maribu/badge-wip/riot-badge.kicad_pcb

## KiCad design riot-badge.kicad_pcb (2025-09-30)

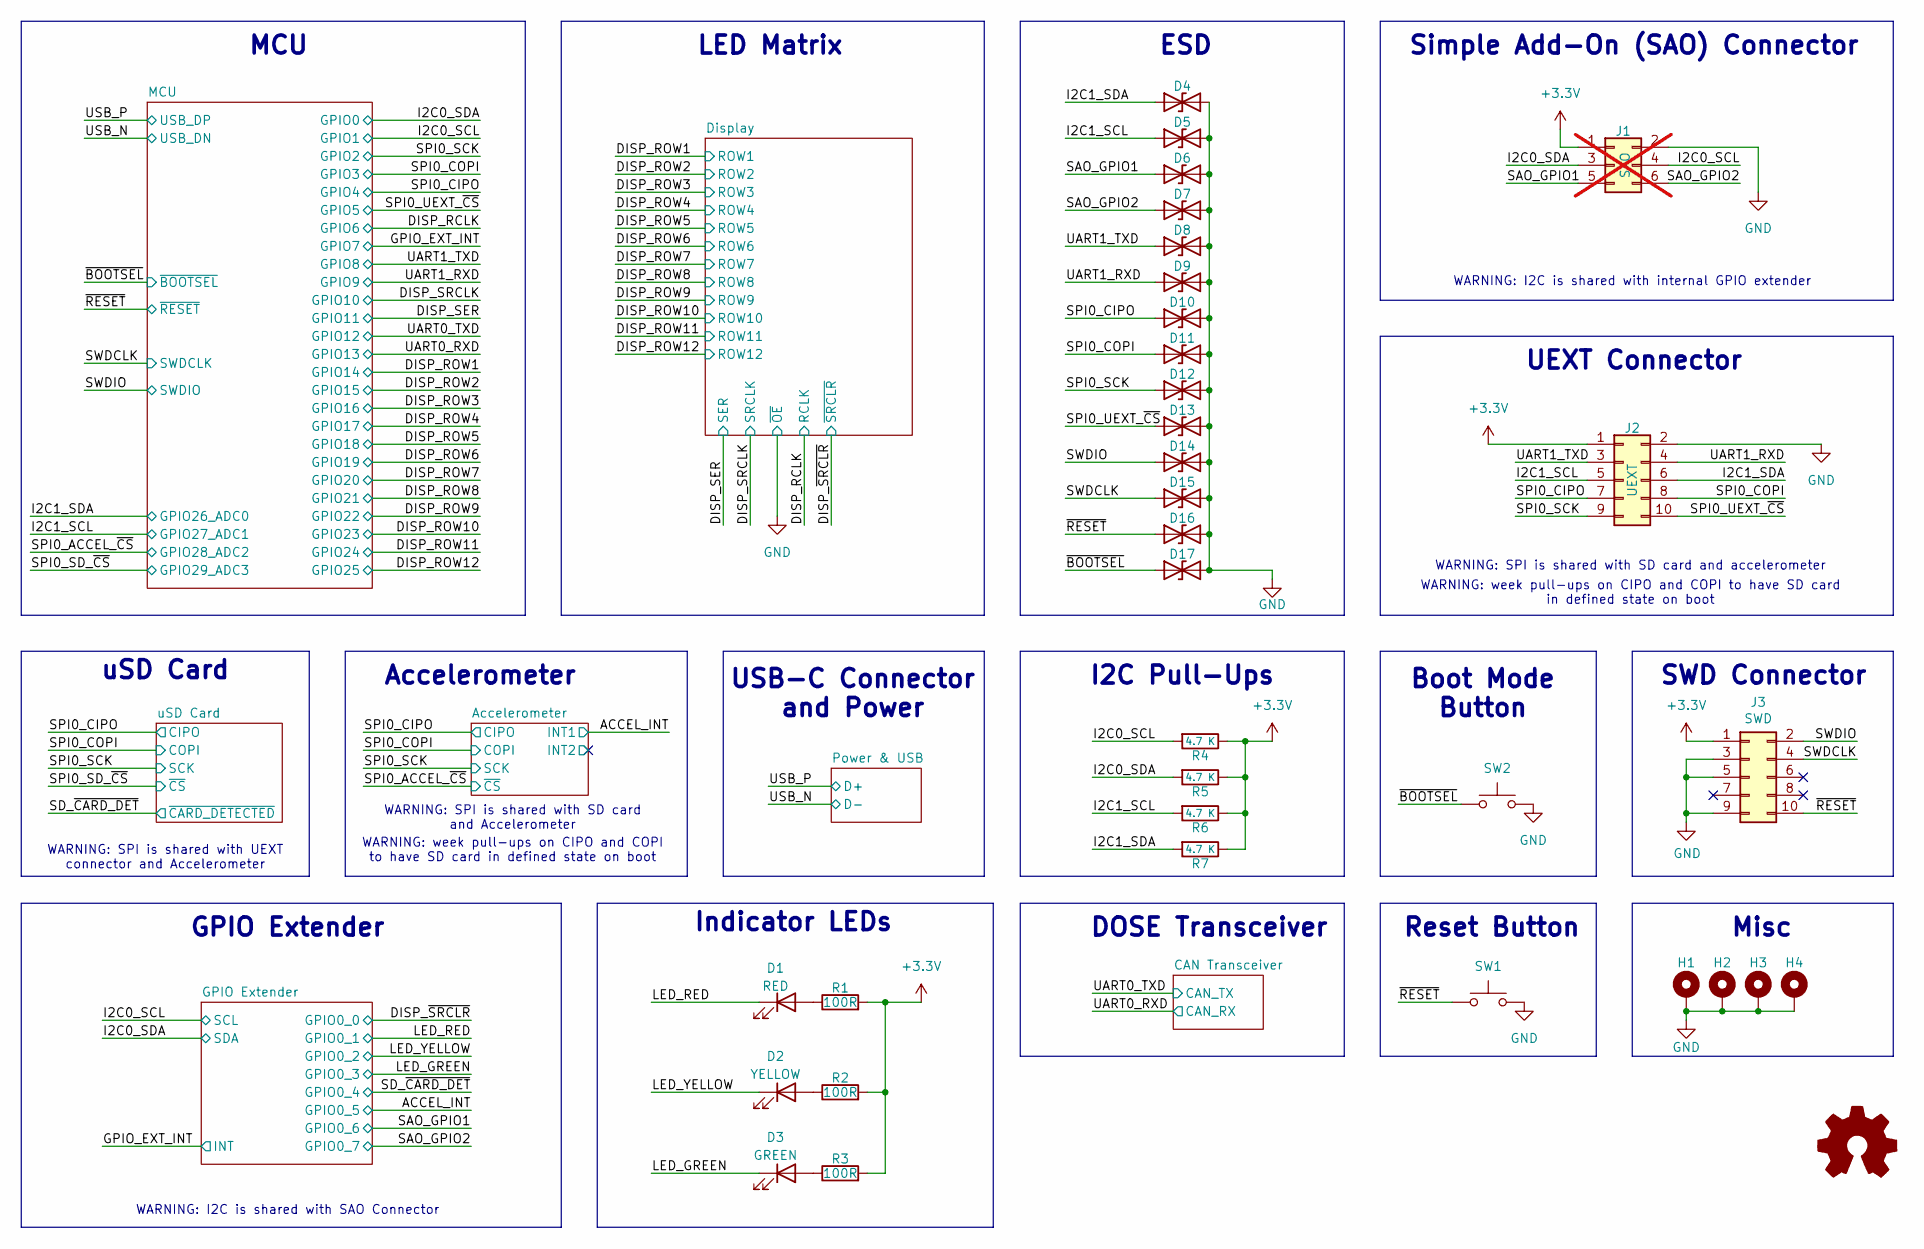
[picture p1: schematic riot-badge.kicad_sch, Badge for RIOT Summit '25]

Parts:
D1: RED; LED_0603_1608Metric; LCSC C2286
D2: YELLOW; LED_0805_2012Metric; LCSC C2296
D3: GREEN; LED_0805_2012Metric; LCSC C2297
D4, D5, D6, D7, D8, D9, D10, D11, D12, D13, D14, D15, D16, D17: D_TVS; SOD-882_L1.0-W0.6-BI; LCSC C7420372
G1: Logo_Open_Hardware_Small; OSHW-Logo2_7.3x6mm_SilkScreen
H1, H2, H3, H4: MountingHole_Pad; MountingHole_2.2mm_M2_DIN965_Pad
J1: SAO; PinSocket_2x03_P2.54mm_Vertical_SAO; LCSC C18164972; not fitted
J2: UEXT; HDR-TH_10P-P2.54-V-F-R2-C5-S2.54_GREENCONN; LCSC C7434489
J3: SWD; CONN-SMD_FTSH-105-01-L-DV-K-TR; LCSC C448647
R1, R2, R3: 100R; R_0402_1005Metric; LCSC C25076
R4, R5, R6, R7: 4.7 K; R_0402_1005Metric; LCSC C25900
SW1, SW2: SW_Push; SW-SMD_4P-L5.1-W5.1-P3.70-LS6.5-TL_H1.5; LCSC C318884

Connections:
+3.3V: J1.1, J2.1, J3.1, R1.2, R2.2, R3.2, R4.1, R5.1, R6.1, R7.1; also elsewhere on the board
/I2C0_SCL: J1.4, R4.2; also elsewhere on the board
/I2C0_SDA: J1.3, R5.2; also elsewhere on the board
/I2C1_SCL: D5.1 (A1), J2.5, R6.2; also elsewhere on the board
/I2C1_SDA: D4.1 (A1), J2.6, R7.2; also elsewhere on the board
/LED_GREEN: D3.1 (K); also elsewhere on the board
/LED_RED: D1.1 (K); also elsewhere on the board
/LED_YELLOW: D2.1 (K); also elsewhere on the board
/SAO_GPIO1: D6.1 (A1), J1.5; also elsewhere on the board
/SAO_GPIO2: D7.1 (A1), J1.6; also elsewhere on the board
/SPI0_CIPO: D10.1 (A1), J2.7; also elsewhere on the board
/SPI0_COPI: D11.1 (A1), J2.8; also elsewhere on the board
/SPI0_SCK: D12.1 (A1), J2.9; also elsewhere on the board
/SPI0_UEXT_~CS: D13.1 (A1), J2.10; also elsewhere on the board
/SWDCLK: D15.1 (A1), J3.4; also elsewhere on the board
/SWDIO: D14.1 (A1), J3.2; also elsewhere on the board
/UART1_RXD: D9.1 (A1), J2.4; also elsewhere on the board
/UART1_TXD: D8.1 (A1), J2.3; also elsewhere on the board
/~BOOTSEL: D17.1 (A1), SW2.1; also elsewhere on the board
/~RESET: D16.1 (A1), J3.10, SW1.1; also elsewhere on the board
GND: D4.2 (A2), D5.2 (A2), D6.2 (A2), D7.2 (A2), D8.2 (A2), D9.2 (A2), D10.2 (A2), D11.2 (A2), D12.2 (A2), D13.2 (A2), D14.2 (A2), D15.2 (A2), D16.2 (A2), D17.2 (A2), H1.1, H2.1, H3.1, H4.1, J1.2, J2.2, J3.3, J3.5, J3.9, SW1.2, SW2.2; also elsewhere on the board
unnamed: D1.2 (A), R1.1
unnamed: D2.2 (A), R2.1
unnamed: D3.2 (A), R3.1

Notes on the sheet:
UEXT Connector
Misc
uSD Card
GPIO Extender
Boot Mode Button
Indicator LEDs
WARNING: week pull-ups on CIPO and COPI to have SD card in defined state on boot
Reset Button
LED Matrix
WARNING: SPI is shared with UEXT connector and Accelerometer
DOSE Transceiver
ESD
WARNING: SPI is shared with SD card and accelerometer
I2C Pull-Ups
WARNING: I2C is shared with internal GPIO extender
WARNING: I2C is shared with SAO Connector
Simple Add-On (SAO) Connector
SWD Connector
WARNING: week pull-ups on CIPO and COPI to have SD card in defined state on boot
USB-C Connector and Power
WARNING: SPI is shared with SD card and Accelerometer
MCU
Accelerometer

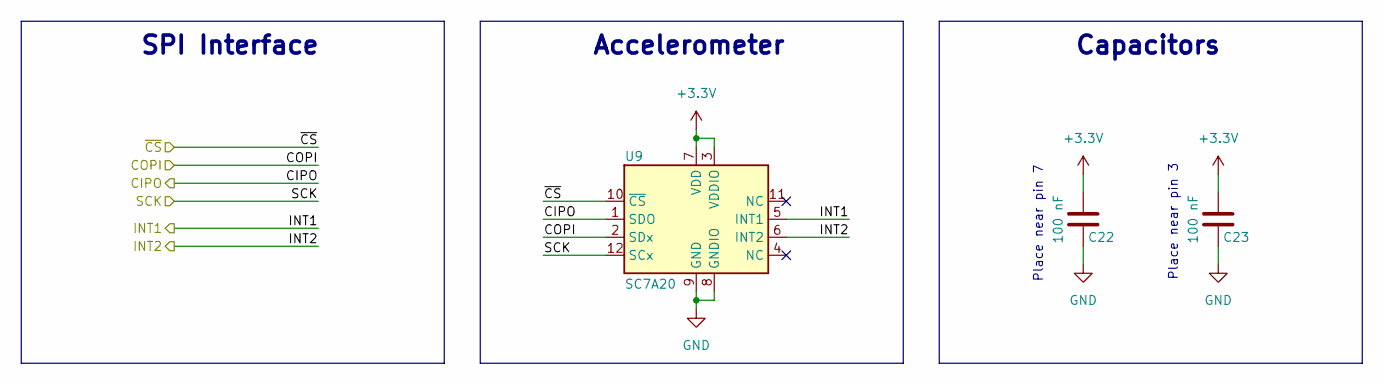
[picture p2: schematic accelerometer.kicad_sch]

Parts:
C22, C23: 100 nF; C_0402_1005Metric; LCSC C1525
U9: SC7A20; LGA-12_2x2mm_P0.5mm

Connections:
+3.3V: C22.1, C23.1, U9.3 (VDDIO), U9.7 (VDD); also elsewhere on the board
/ACCEL_INT: U9.5 (INT1); also elsewhere on the board
/Accelerometer/INT2: U9.6 (INT2)
/SPI0_ACCEL_~CS: U9.10 (~CS); also elsewhere on the board
/SPI0_CIPO: U9.1 (SDO); also elsewhere on the board
/SPI0_COPI: U9.2 (SDx); also elsewhere on the board
/SPI0_SCK: U9.12 (SCx); also elsewhere on the board
GND: C22.2, C23.2, U9.8 (GNDIO), U9.9 (GND); also elsewhere on the board

Notes on the sheet:
SPI Interface
Capacitors
Place near pin 7
Place near pin 3
Accelerometer

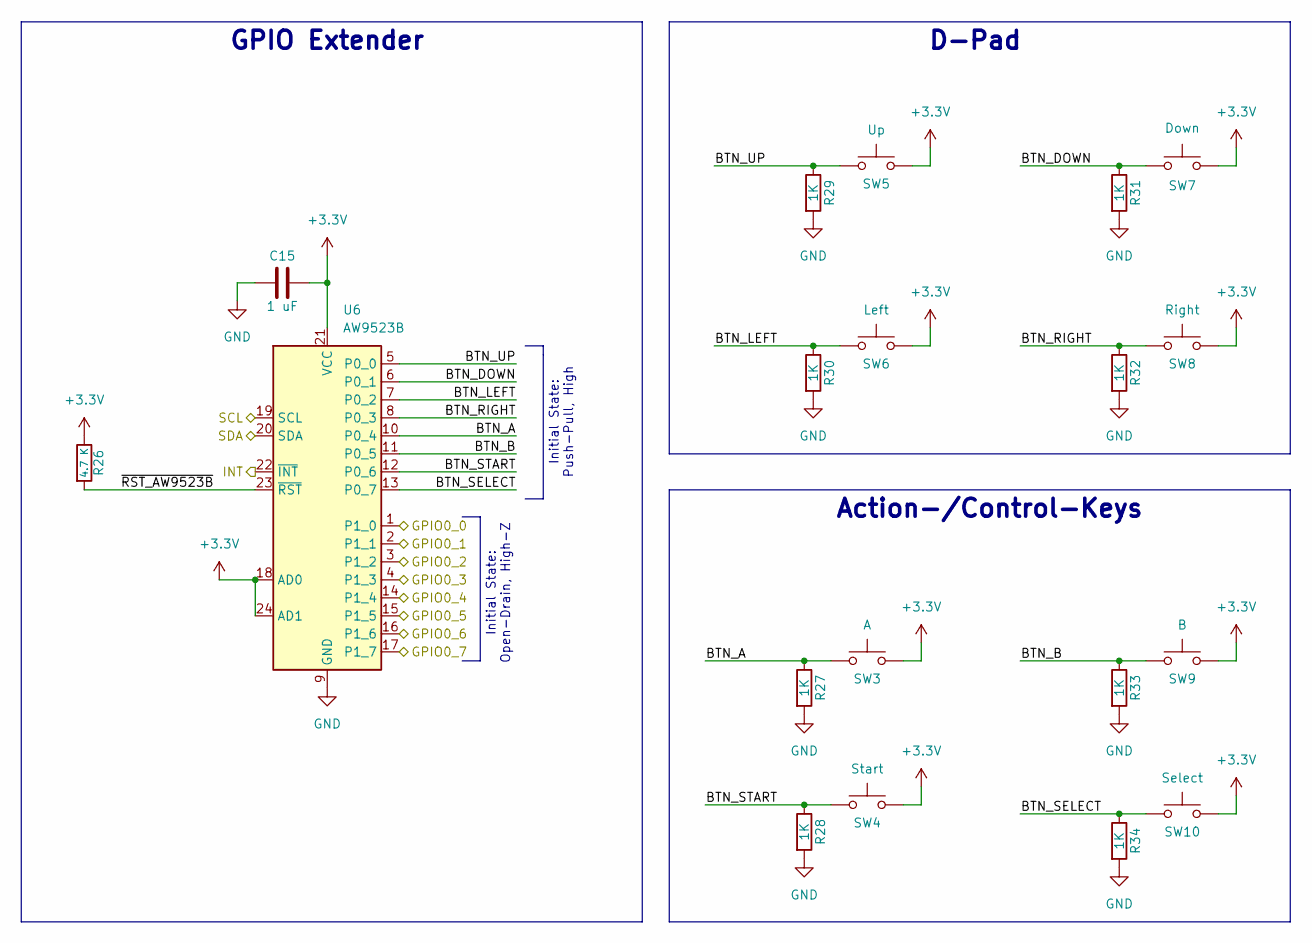
[picture p3: schematic gpio_extender.kicad_sch, Badge for RIOT Summit '25]

Parts:
C15: 1 uF; C_0402_1005Metric; LCSC C52923
R26: 4.7 K; R_0402_1005Metric; LCSC C25900
R27, R28, R29, R30, R31, R32, R33, R34: 1K; R_0402_1005Metric; LCSC C11702
SW3, SW4, SW5, SW6, SW7, SW8, SW9, SW10: SW_Push; SW-SMD_4P-L5.1-W5.1-P3.70-LS6.5-TL_H1.5; LCSC C318884
U6: AW9523B; QFN-24-1EP_4x4mm_P0.5mm_EP2.7x2.7mm

Connections:
+3.3V: C15.2, R26.1, SW3.2, SW4.2, SW5.2, SW6.2, SW7.2, SW8.2, SW9.2, SW10.2, U6.18 (AD0), U6.21 (VCC), U6.24 (AD1); also elsewhere on the board
/ACCEL_INT: U6.15 (P1_5); also elsewhere on the board
/DISP_~SRCLR: U6.1 (P1_0); also elsewhere on the board
/GPIO Extender/BTN_A: R27.1, SW3.1, U6.10 (P0_4)
/GPIO Extender/BTN_B: R33.1, SW9.1, U6.11 (P0_5)
/GPIO Extender/BTN_DOWN: R31.1, SW7.1, U6.6 (P0_1)
/GPIO Extender/BTN_LEFT: R30.1, SW6.1, U6.7 (P0_2)
/GPIO Extender/BTN_RIGHT: R32.1, SW8.1, U6.8 (P0_3)
/GPIO Extender/BTN_SELECT: R34.1, SW10.1, U6.13 (P0_7)
/GPIO Extender/BTN_START: R28.1, SW4.1, U6.12 (P0_6)
/GPIO Extender/BTN_UP: R29.1, SW5.1, U6.5 (P0_0)
/GPIO Extender/~RST_AW9523B: R26.2, U6.23 (~RST)
/GPIO_EXT_INT: U6.22 (~INT); also elsewhere on the board
/I2C0_SCL: U6.19 (SCL); also elsewhere on the board
/I2C0_SDA: U6.20 (SDA); also elsewhere on the board
/LED_GREEN: U6.4 (P1_3); also elsewhere on the board
/LED_RED: U6.2 (P1_1); also elsewhere on the board
/LED_YELLOW: U6.3 (P1_2); also elsewhere on the board
/SAO_GPIO1: U6.16 (P1_6); also elsewhere on the board
/SAO_GPIO2: U6.17 (P1_7); also elsewhere on the board
/SD_~CARD_DET: U6.14 (P1_4); also elsewhere on the board
GND: C15.1, R27.2, R28.2, R29.2, R30.2, R31.2, R32.2, R33.2, R34.2, U6.9 (GND), U6.25 (GND); also elsewhere on the board

Notes on the sheet:
Initial State: Push-Pull, High
D-Pad
Action-/Control-Keys
GPIO Extender
Initial State: Open-Drain, High-Z

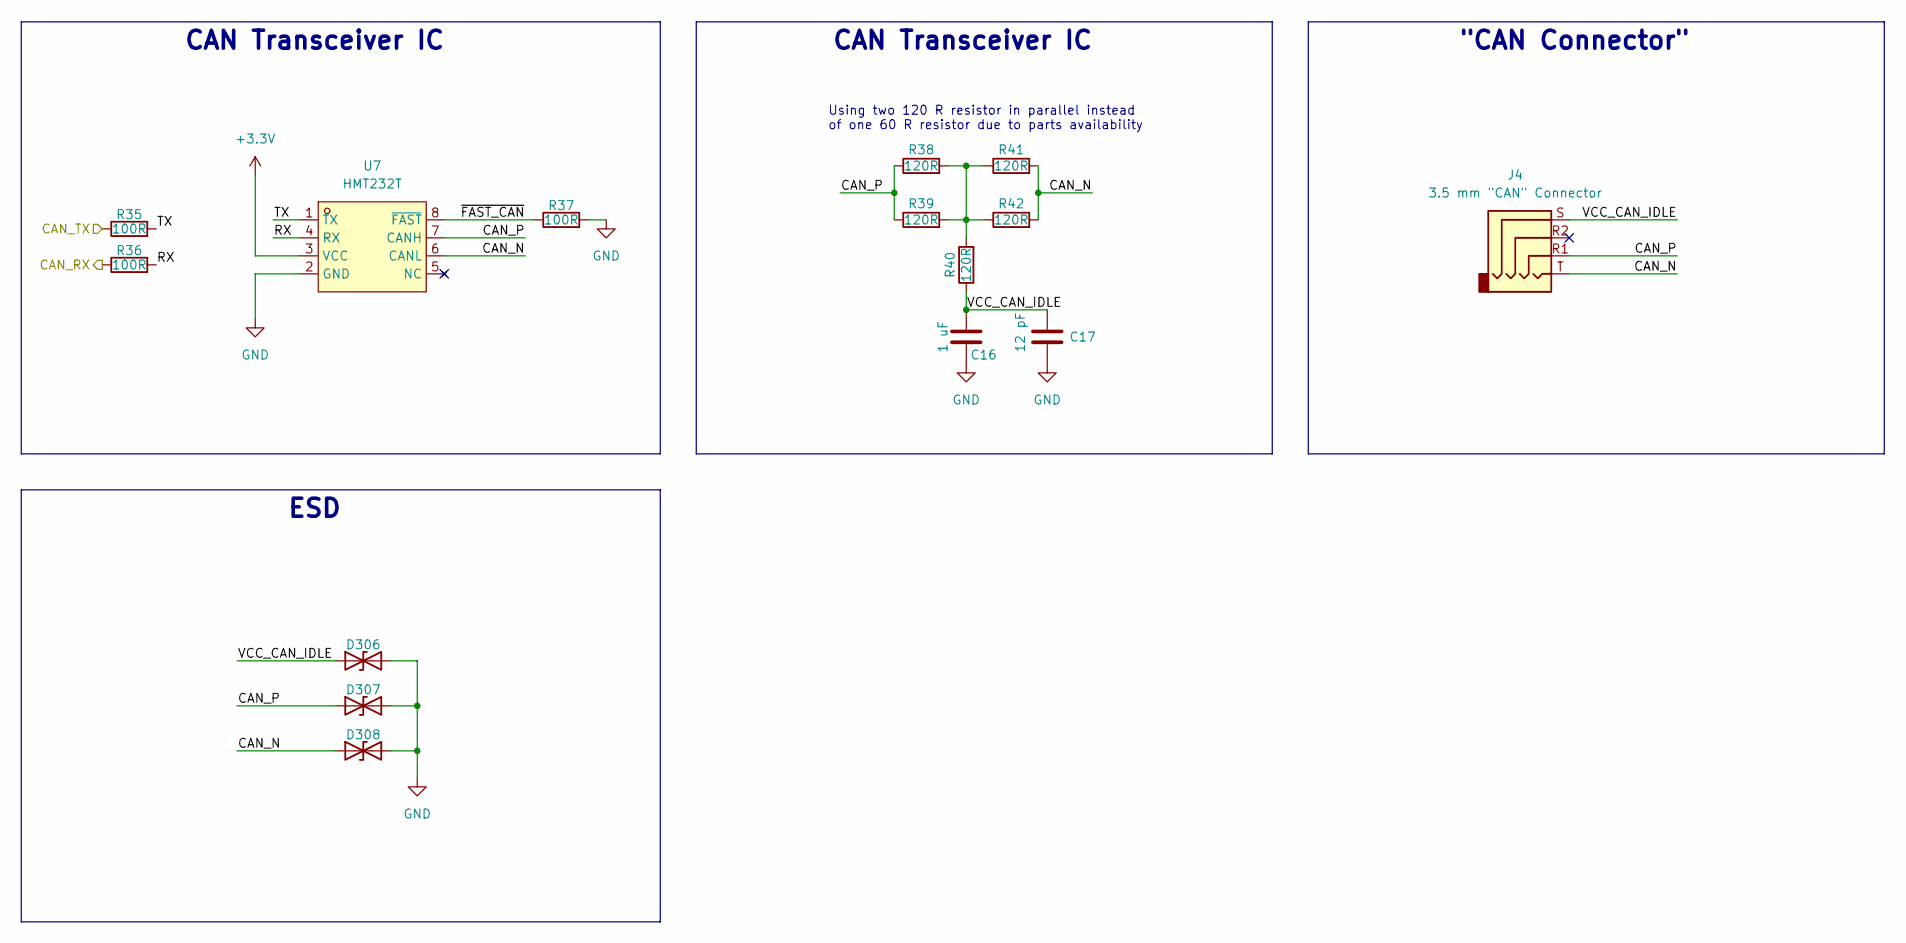
[picture p4: schematic can_transceiver.kicad_sch, Badge for RIOT Summit '25]

Parts:
C16: 1 uF; C_0402_1005Metric; LCSC C52923
C17: 12 pF; C_0402_1005Metric; LCSC C1547
D306, D307, D308: D_TVS; SOD-882_L1.0-W0.6-BI; LCSC C7420372
J4: 3.5 mm "CAN" Connector; Jack_3.5mm_PJ-320D; LCSC C22459515
R35, R36, R37: 100R; R_0402_1005Metric; LCSC C25076
R38, R39, R40, R41, R42: 120R; R_0402_1005Metric; LCSC C25079
U7: HMT232T; SOIC-8_3.9x4.9mm_P1.27mm; LCSC C45662327

Connections:
+3.3V: U7.3 (VCC); also elsewhere on the board
/CAN Transceiver/CAN_N: D308.1 (A1), J4.T, R41.2, R42.2, U7.6 (CANL)
/CAN Transceiver/CAN_P: D307.1 (A1), J4.R1, R38.1, R39.1, U7.7 (CANH)
/CAN Transceiver/RX: R36.2, U7.4 (RX)
/CAN Transceiver/TX: R35.2, U7.1 (TX)
/CAN Transceiver/VCC_CAN_IDLE: C16.1, C17.1, D306.1 (A1), J4.S, R40.1
/CAN Transceiver/~FAST_CAN: R37.1, U7.8 (~FAST)
/UART0_RXD: R36.1; also elsewhere on the board
/UART0_TXD: R35.1; also elsewhere on the board
GND: C16.2, C17.2, D306.2 (A2), D307.2 (A2), D308.2 (A2), R37.2, U7.2 (GND); also elsewhere on the board
unnamed: R38.2, R39.2, R40.2, R41.1, R42.1

Notes on the sheet:
"CAN Connector"
CAN Transceiver IC
ESD
Using two 120 R resistor in parallel instead of one 60 R resistor due to parts availability

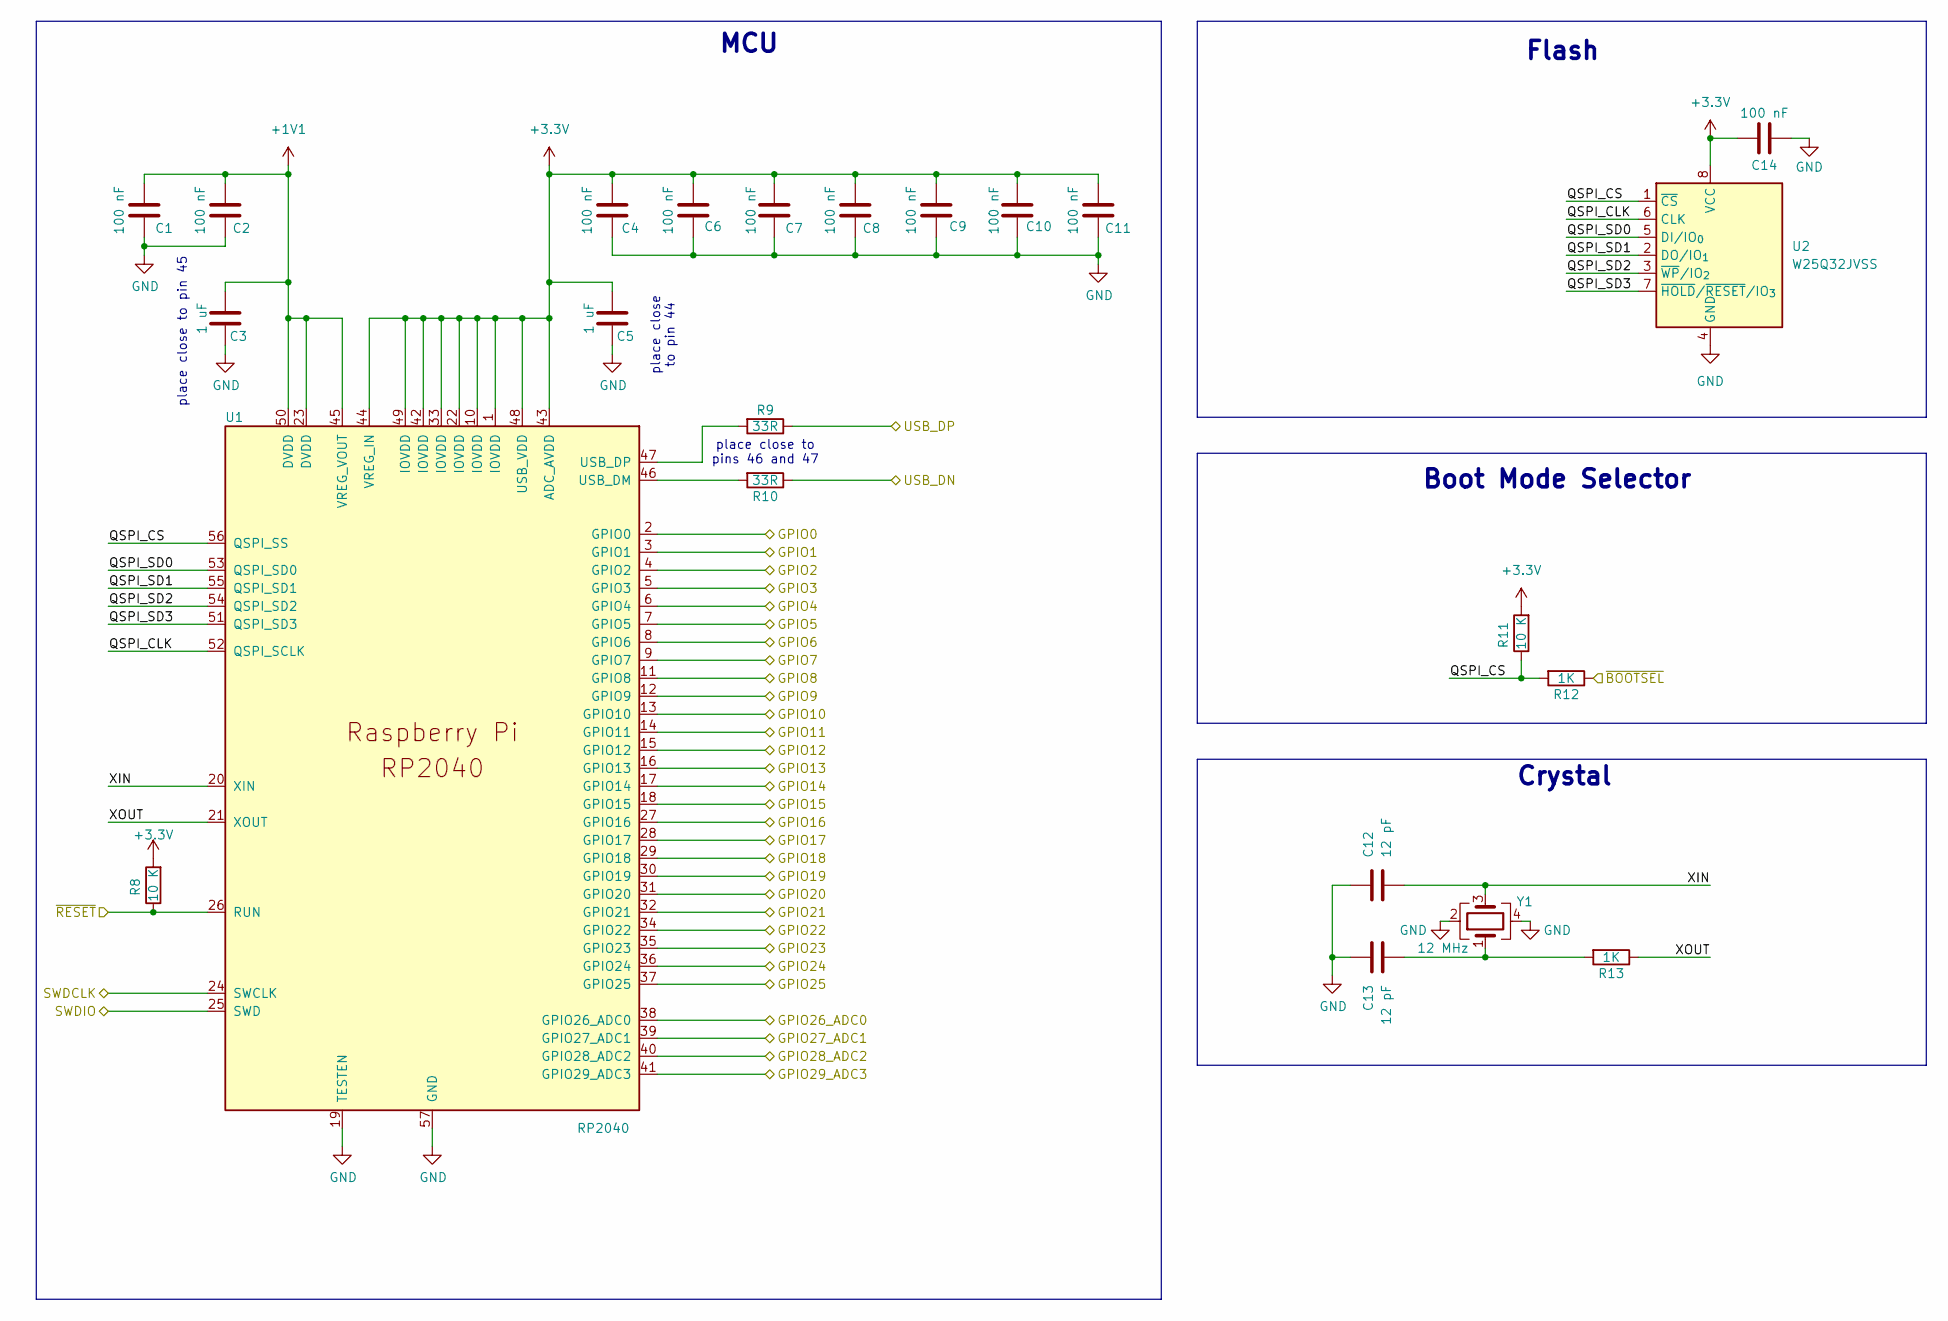
[picture p5: schematic mcu.kicad_sch, Badge for RIOT Summit '25]

Parts:
C1, C2, C4, C6, C7, C8, C9, C10, C11, C14: 100 nF; C_0402_1005Metric; LCSC C1525
C3, C5: 1 uF; C_0402_1005Metric; LCSC C52923
C12, C13: 12 pF; C_0402_1005Metric; LCSC C1547
R8, R11: 10 K; R_0402_1005Metric; LCSC C25744
R9, R10: 33R; R_0402_1005Metric; LCSC C25105
R12, R13: 1K; R_0402_1005Metric; LCSC C11702
U1: RP2040; RP2040-QFN-56; LCSC C2040
U2: W25Q32JVSS; SOIC-8_5.3x5.3mm_P1.27mm
Y1: 12 MHz; Crystal_SMD_3225-4Pin_3.2x2.5mm; LCSC C9002

Connections:
+1V1: C1.1, C2.2, C3.1, U1.23 (DVDD), U1.45 (VREG_VOUT), U1.50 (DVDD)
+3.3V: C4.1, C5.1, C6.1, C7.1, C8.2, C9.1, C10.1, C11.1, C14.1, R8.2, R11.2, U1.1 (IOVDD), U1.10 (IOVDD), U1.22 (IOVDD), U1.33 (IOVDD), U1.42 (IOVDD), U1.43 (ADC_AVDD), U1.44 (VREG_IN), U1.48 (USB_VDD), U1.49 (IOVDD), U2.8 (VCC); also elsewhere on the board
/DISP_RCLK: U1.8 (GPIO6); also elsewhere on the board
/DISP_ROW1: U1.17 (GPIO14); also elsewhere on the board
/DISP_ROW2: U1.18 (GPIO15); also elsewhere on the board
/DISP_ROW3: U1.27 (GPIO16); also elsewhere on the board
/DISP_ROW4: U1.28 (GPIO17); also elsewhere on the board
/DISP_ROW5: U1.29 (GPIO18); also elsewhere on the board
/DISP_ROW6: U1.30 (GPIO19); also elsewhere on the board
/DISP_ROW7: U1.31 (GPIO20); also elsewhere on the board
/DISP_ROW8: U1.32 (GPIO21); also elsewhere on the board
/DISP_ROW9: U1.34 (GPIO22); also elsewhere on the board
/DISP_ROW10: U1.35 (GPIO23); also elsewhere on the board
/DISP_ROW11: U1.36 (GPIO24); also elsewhere on the board
/DISP_ROW12: U1.37 (GPIO25); also elsewhere on the board
/DISP_SER: U1.14 (GPIO11); also elsewhere on the board
/DISP_SRCLK: U1.13 (GPIO10); also elsewhere on the board
/GPIO_EXT_INT: U1.9 (GPIO7); also elsewhere on the board
/I2C0_SCL: U1.3 (GPIO1); also elsewhere on the board
/I2C0_SDA: U1.2 (GPIO0); also elsewhere on the board
/I2C1_SCL: U1.39 (GPIO27_ADC1); also elsewhere on the board
/I2C1_SDA: U1.38 (GPIO26_ADC0); also elsewhere on the board
/MCU/QSPI_CLK: U1.52 (QSPI_SCLK), U2.6 (CLK)
/MCU/QSPI_CS: R11.1, R12.2, U1.56 (QSPI_SS), U2.1 (~CS)
/MCU/QSPI_SD0: U1.53 (QSPI_SD0), U2.5 (DI/IO_{0})
/MCU/QSPI_SD1: U1.55 (QSPI_SD1), U2.2 (DO/IO_{1})
/MCU/QSPI_SD2: U1.54 (QSPI_SD2), U2.3 (~WP/IO_{2})
/MCU/QSPI_SD3: U1.51 (QSPI_SD3), U2.7 (~HOLD/~RESET/IO_{3})
/MCU/XIN: C12.2, U1.20 (XIN), Y1.3
/MCU/XOUT: R13.1, U1.21 (XOUT)
/SPI0_ACCEL_~CS: U1.40 (GPIO28_ADC2); also elsewhere on the board
/SPI0_CIPO: U1.6 (GPIO4); also elsewhere on the board
/SPI0_COPI: U1.5 (GPIO3); also elsewhere on the board
/SPI0_SCK: U1.4 (GPIO2); also elsewhere on the board
/SPI0_SD_~CS: U1.41 (GPIO29_ADC3); also elsewhere on the board
/SPI0_UEXT_~CS: U1.7 (GPIO5); also elsewhere on the board
/SWDCLK: U1.24 (SWCLK); also elsewhere on the board
/SWDIO: U1.25 (SWD); also elsewhere on the board
/UART0_RXD: U1.16 (GPIO13); also elsewhere on the board
/UART0_TXD: U1.15 (GPIO12); also elsewhere on the board
/UART1_RXD: U1.12 (GPIO9); also elsewhere on the board
/UART1_TXD: U1.11 (GPIO8); also elsewhere on the board
/USB_N: R10.1; also elsewhere on the board
/USB_P: R9.1; also elsewhere on the board
/~BOOTSEL: R12.1; also elsewhere on the board
/~RESET: R8.1, U1.26 (RUN); also elsewhere on the board
GND: C1.2, C2.1, C3.2, C4.2, C5.2, C6.2, C7.2, C8.1, C9.2, C10.2, C11.2, C12.1, C13.1, C14.2, U1.19 (TESTEN), U1.57 (GND), U2.4 (GND), Y1.2, Y1.4; also elsewhere on the board
unnamed: C13.2, R13.2, Y1.1
unnamed: R10.2, U1.46 (USB_DM)
unnamed: R9.2, U1.47 (USB_DP)

Notes on the sheet:
Crystal
Flash
Boot Mode Selector
place close to pins 46 and 47
place close to pin 44
place close to pin 45
MCU

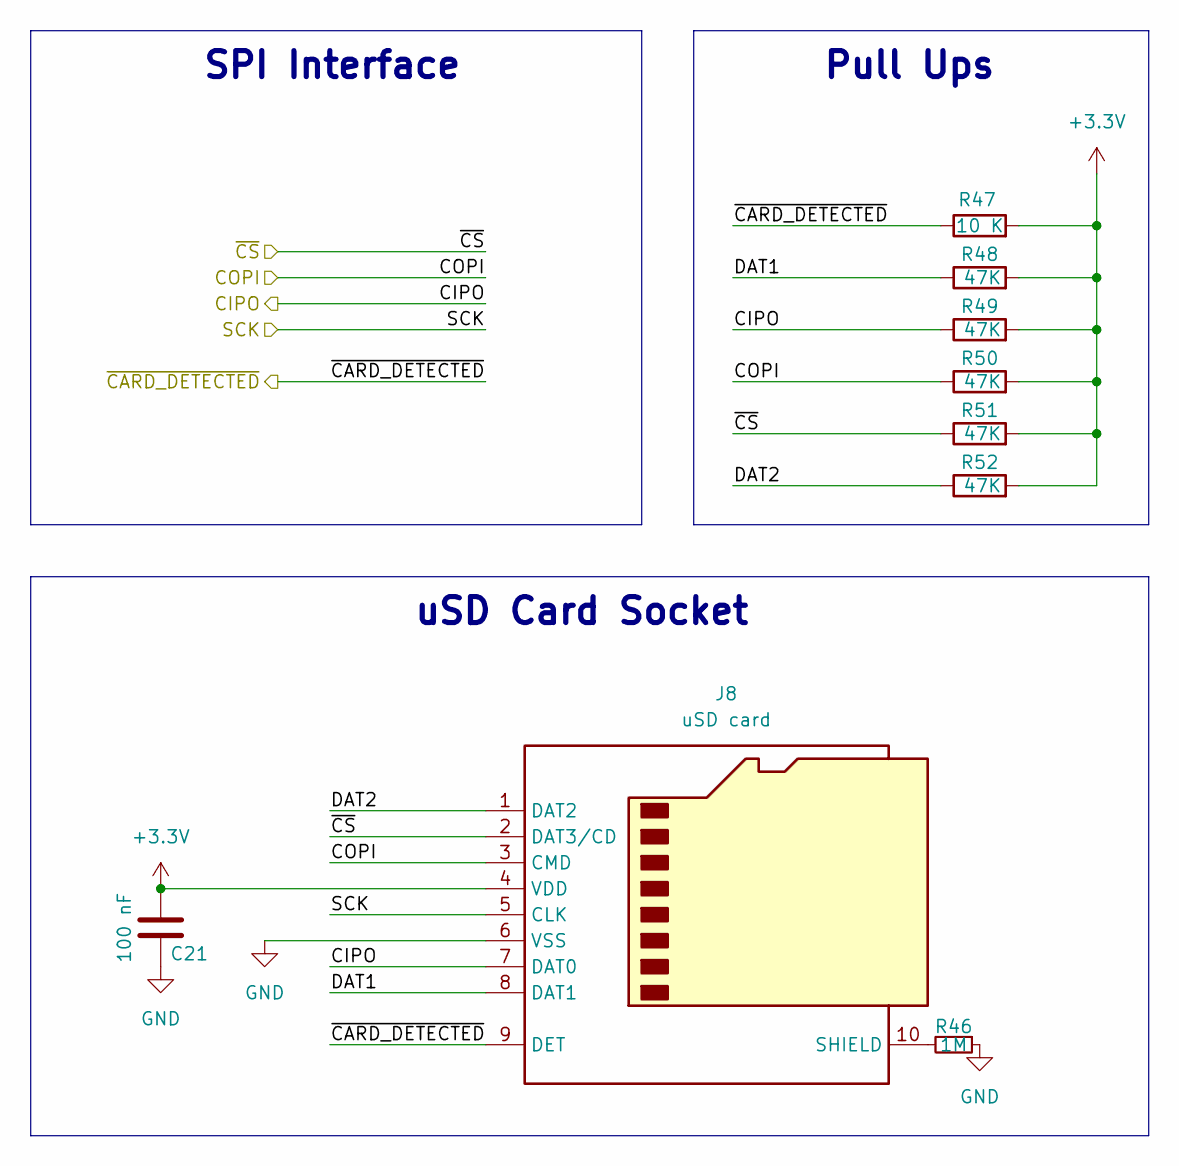
[picture p6: schematic sd_card.kicad_sch]

Parts:
C21: 100 nF; C_0402_1005Metric; LCSC C1525
J8: uSD card; uSD_CARD; LCSC C5454948
R46: 1M; R_0402_1005Metric; LCSC C26083
R47: 10 K; R_0402_1005Metric; LCSC C25744
R48, R49, R50, R51, R52: 47K; R_0402_1005Metric; LCSC C25792

Connections:
+3.3V: C21.1, J8.4 (VDD), R47.2, R48.2, R49.2, R50.2, R51.2, R52.2; also elsewhere on the board
/SD_~CARD_DET: J8.9 (DET), R47.1; also elsewhere on the board
/SPI0_CIPO: J8.7 (DAT0), R49.1; also elsewhere on the board
/SPI0_COPI: J8.3 (CMD), R50.1; also elsewhere on the board
/SPI0_SCK: J8.5 (CLK); also elsewhere on the board
/SPI0_SD_~CS: J8.2 (DAT3/CD), R51.1; also elsewhere on the board
/uSD Card/DAT1: J8.8 (DAT1), R48.1
/uSD Card/DAT2: J8.1 (DAT2), R52.1
GND: C21.2, J8.6 (VSS), R46.1; also elsewhere on the board
unnamed: J8.10 (SHIELD), R46.2

Notes on the sheet:
Pull Ups
uSD Card Socket
SPI Interface

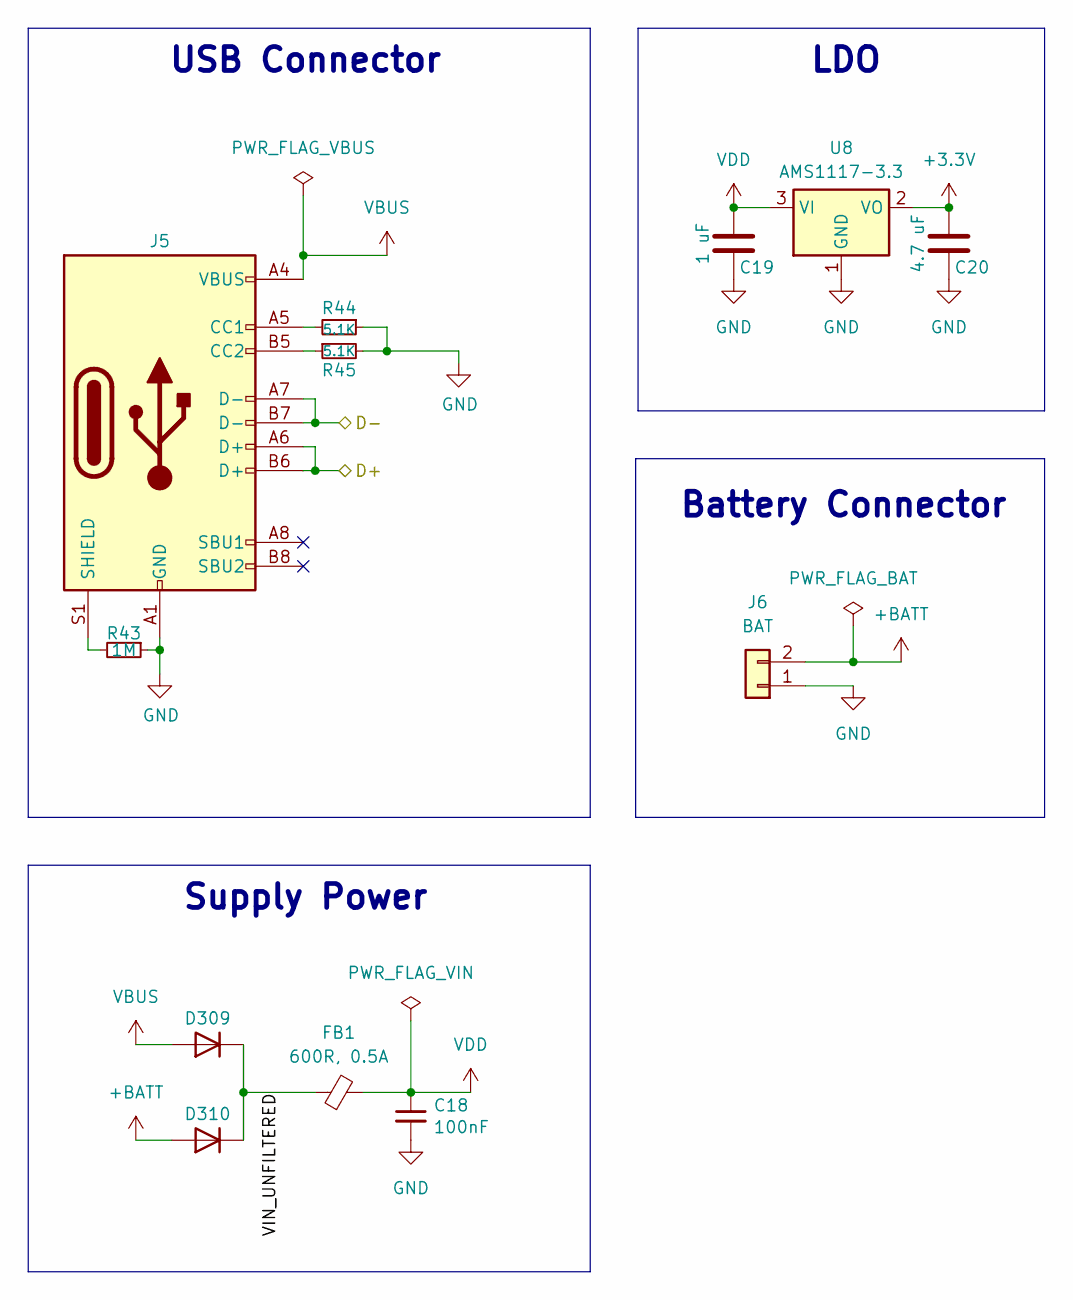
[picture p7: schematic power_usb.kicad_sch, Badge for RIOT Summit '25]

Parts:
C18: 100nF; C_0402_1005Metric; LCSC C1525
C19: 1 uF; C_0402_1005Metric; LCSC C52923
C20: 4.7 uF; C_0402_1005Metric; LCSC C23733
D309, D310: D; D_SOD-123; LCSC C64898
FB1: 600R, 0.5A; L_0805_2012Metric; LCSC C1017
J5: USB_C_Receptacle_USB2.0_16P; USB_C_Receptacle_GCT_USB4105-xx-A_16P_TopMnt_Horizontal; LCSC C165948
J6: BAT; CONN-TH_2P-P2.00_KINGHELM_KH-PH-2P-Z; LCSC C2898945
R43: 1M; R_0402_1005Metric; LCSC C26083
R44, R45: 5.1K; R_0402_1005Metric; LCSC C25905
U8: AMS1117-3.3; SOT-223-3_TabPin2; LCSC C6186

Connections:
+3.3V: C20.1, U8.2 (VO); also elsewhere on the board
+BATT: D310.2 (A), J6.2
/Power & USB/VIN_UNFILTERED: D309.1 (K), D310.1 (K), FB1.1
/USB_N: J5.A7 (D-), J5.B7 (D-); also elsewhere on the board
/USB_P: J5.A6 (D+), J5.B6 (D+); also elsewhere on the board
GND: C18.2, C19.2, C20.2, J5.A1 (GND), J5.A12 (GND), J5.B1 (GND), J5.B12 (GND), J6.1, R43.1, R44.1, R45.2, U8.1 (GND); also elsewhere on the board
unnamed: J5.A5 (CC1), R44.2
unnamed: J5.B5 (CC2), R45.1
unnamed: J5.S1 (SHIELD), R43.2
VBUS: D309.2 (A), J5.A4 (VBUS), J5.A9 (VBUS), J5.B4 (VBUS), J5.B9 (VBUS)
VDD: C18.1, C19.1, FB1.2, U8.3 (VI)

Notes on the sheet:
LDO
USB Connector
Battery Connector
Supply Power
