maribu/badge-wip/riot-badge.kicad_pcb

## KiCad design riot-badge.kicad_pcb (continued)

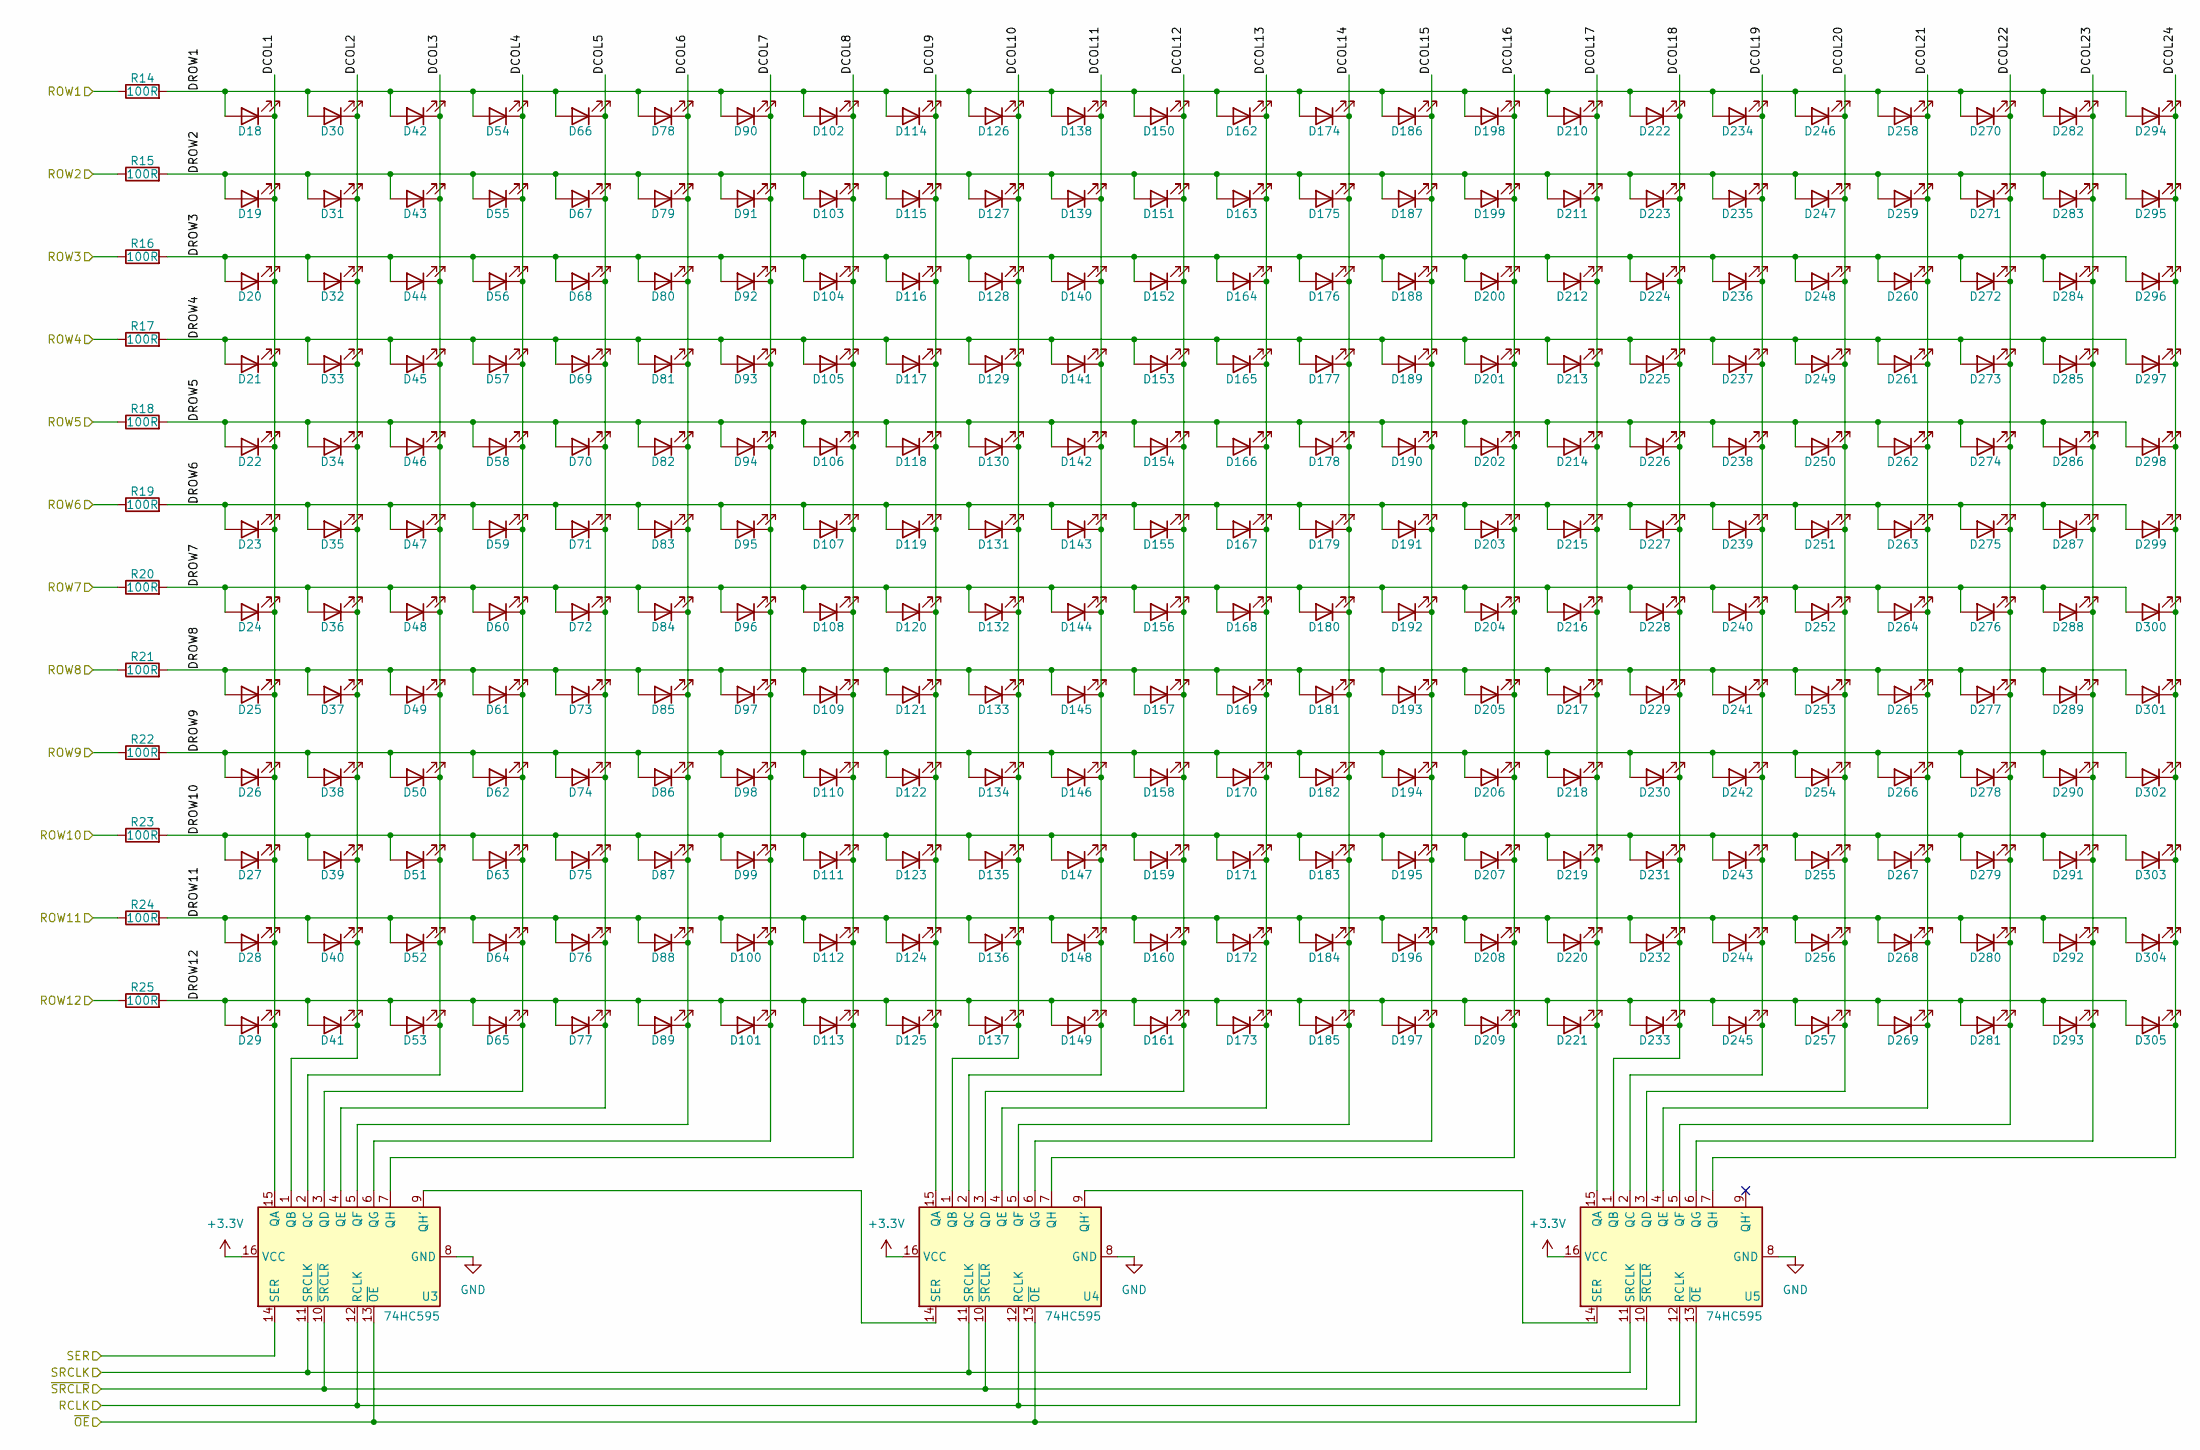
[picture p8: schematic display.kicad_sch, Badge for RIOT Summit '25]

Parts:
D18, D19, D20, D21, D22, D23, D24, D25, D26, D27, D28, D29, D30, D31, D32, D33, D34, D35, D36, D37, D38, D39, D40, D41, D42, D43, D44, D45, D46, D47, D48, D49, D50, D51, D52, D53, D54, D55, D56, D57, D58, D59, D60, D61, D62, D63, D64, D65, D66, D67, D68, D69, D70, D71, D72, D73, D74, D75, D76, D77, D78, D79, D80, D81, D82, D83, D84, D85, D86, D87, D88, D89, D90, D91, D92, D93, D94, D95, D96, D97, D98, D99, D100, D101, D102, D103, D104, D105, D106, D107, D108, D109, D110, D111, D112, D113, D114, D115, D116, D117, D118, D119, D120, D121, D122, D123, D124, D125, D126, D127, D128, D129, D130, D131, D132, D133, D134, D135, D136, D137, D138, D139, D140, D141, D142, D143, D144, D145, D146, D147, D148, D149, D150, D151, D152, D153, D154, D155, D156, D157, D158, D159, D160, D161, D162, D163, D164, D165, D166, D167, D168, D169, D170, D171, D172, D173, D174, D175, D176, D177, D178, D179, D180, D181, D182, D183, D184, D185, D186, D187, D188, D189, D190, D191, D192, D193, D194, D195, D196, D197, D198, D199, D200, D201, D202, D203, D204, D205, D206, D207, D208, D209, D210, D211, D212, D213, D214, D215, D216, D217, D218, D219, D220, D221, D222, D223, D224, D225, D226, D227, D228, D229, D230, D231, D232, D233, D234, D235, D236, D237, D238, D239, D240, D241, D242, D243, D244, D245, D246, D247, D248, D249, D250, D251, D252, D253, D254, D255, D256, D257, D258, D259, D260, D261, D262, D263, D264, D265, D266, D267, D268, D269, D270, D271, D272, D273, D274, D275, D276, D277, D278, D279, D280, D281, D282, D283, D284, D285, D286, D287, D288, D289, D290, D291, D292, D293, D294, D295, D296, D297, D298, D299, D300, D301, D302, D303, D304, D305: LED-White; LED_0603_1608Metric; LCSC C2290
R14, R15, R16, R17, R18, R19, R20, R21, R22, R23, R24, R25: 100R; R_0402_1005Metric; LCSC C25076
U3, U4, U5: 74HC595; SOIC-16_3.9x9.9mm_P1.27mm; LCSC C5947

Connections:
+3.3V: U3.16 (VCC), U4.16 (VCC), U5.16 (VCC); also elsewhere on the board
/DISP_RCLK: U3.12 (RCLK), U4.12 (RCLK), U5.12 (RCLK); also elsewhere on the board
/DISP_ROW1: R14.1; also elsewhere on the board
/DISP_ROW2: R15.1; also elsewhere on the board
/DISP_ROW3: R16.1; also elsewhere on the board
/DISP_ROW4: R17.1; also elsewhere on the board
/DISP_ROW5: R18.1; also elsewhere on the board
/DISP_ROW6: R19.1; also elsewhere on the board
/DISP_ROW7: R20.1; also elsewhere on the board
/DISP_ROW8: R21.1; also elsewhere on the board
/DISP_ROW9: R22.1; also elsewhere on the board
/DISP_ROW10: R23.1; also elsewhere on the board
/DISP_ROW11: R24.1; also elsewhere on the board
/DISP_ROW12: R25.1; also elsewhere on the board
/DISP_SER: U3.14 (SER); also elsewhere on the board
/DISP_SRCLK: U3.11 (SRCLK), U4.11 (SRCLK), U5.11 (SRCLK); also elsewhere on the board
/DISP_~SRCLR: U3.10 (~SRCLR), U4.10 (~SRCLR), U5.10 (~SRCLR); also elsewhere on the board
/Display/DCOL1: D18.1 (K), D19.1 (K), D20.1 (K), D21.1 (K), D22.1 (K), D23.1 (K), D24.1 (K), D25.1 (K), D26.1 (K), D27.1 (K), D28.1 (K), D29.1 (K), U3.15 (QA)
/Display/DCOL2: D30.1 (K), D31.1 (K), D32.1 (K), D33.1 (K), D34.1 (K), D35.1 (K), D36.1 (K), D37.1 (K), D38.1 (K), D39.1 (K), D40.1 (K), D41.1 (K), U3.1 (QB)
/Display/DCOL3: D42.1 (K), D43.1 (K), D44.1 (K), D45.1 (K), D46.1 (K), D47.1 (K), D48.1 (K), D49.1 (K), D50.1 (K), D51.1 (K), D52.1 (K), D53.1 (K), U3.2 (QC)
/Display/DCOL4: D54.1 (K), D55.1 (K), D56.1 (K), D57.1 (K), D58.1 (K), D59.1 (K), D60.1 (K), D61.1 (K), D62.1 (K), D63.1 (K), D64.1 (K), D65.1 (K), U3.3 (QD)
/Display/DCOL5: D66.1 (K), D67.1 (K), D68.1 (K), D69.1 (K), D70.1 (K), D71.1 (K), D72.1 (K), D73.1 (K), D74.1 (K), D75.1 (K), D76.1 (K), D77.1 (K), U3.4 (QE)
/Display/DCOL6: D78.1 (K), D79.1 (K), D80.1 (K), D81.1 (K), D82.1 (K), D83.1 (K), D84.1 (K), D85.1 (K), D86.1 (K), D87.1 (K), D88.1 (K), D89.1 (K), U3.5 (QF)
/Display/DCOL7: D90.1 (K), D91.1 (K), D92.1 (K), D93.1 (K), D94.1 (K), D95.1 (K), D96.1 (K), D97.1 (K), D98.1 (K), D99.1 (K), D100.1 (K), D101.1 (K), U3.6 (QG)
/Display/DCOL8: D102.1 (K), D103.1 (K), D104.1 (K), D105.1 (K), D106.1 (K), D107.1 (K), D108.1 (K), D109.1 (K), D110.1 (K), D111.1 (K), D112.1 (K), D113.1 (K), U3.7 (QH)
/Display/DCOL9: D114.1 (K), D115.1 (K), D116.1 (K), D117.1 (K), D118.1 (K), D119.1 (K), D120.1 (K), D121.1 (K), D122.1 (K), D123.1 (K), D124.1 (K), D125.1 (K), U4.15 (QA)
/Display/DCOL10: D126.1 (K), D127.1 (K), D128.1 (K), D129.1 (K), D130.1 (K), D131.1 (K), D132.1 (K), D133.1 (K), D134.1 (K), D135.1 (K), D136.1 (K), D137.1 (K), U4.1 (QB)
/Display/DCOL11: D138.1 (K), D139.1 (K), D140.1 (K), D141.1 (K), D142.1 (K), D143.1 (K), D144.1 (K), D145.1 (K), D146.1 (K), D147.1 (K), D148.1 (K), D149.1 (K), U4.2 (QC)
/Display/DCOL12: D150.1 (K), D151.1 (K), D152.1 (K), D153.1 (K), D154.1 (K), D155.1 (K), D156.1 (K), D157.1 (K), D158.1 (K), D159.1 (K), D160.1 (K), D161.1 (K), U4.3 (QD)
/Display/DCOL13: D162.1 (K), D163.1 (K), D164.1 (K), D165.1 (K), D166.1 (K), D167.1 (K), D168.1 (K), D169.1 (K), D170.1 (K), D171.1 (K), D172.1 (K), D173.1 (K), U4.4 (QE)
/Display/DCOL14: D174.1 (K), D175.1 (K), D176.1 (K), D177.1 (K), D178.1 (K), D179.1 (K), D180.1 (K), D181.1 (K), D182.1 (K), D183.1 (K), D184.1 (K), D185.1 (K), U4.5 (QF)
/Display/DCOL15: D186.1 (K), D187.1 (K), D188.1 (K), D189.1 (K), D190.1 (K), D191.1 (K), D192.1 (K), D193.1 (K), D194.1 (K), D195.1 (K), D196.1 (K), D197.1 (K), U4.6 (QG)
/Display/DCOL16: D198.1 (K), D199.1 (K), D200.1 (K), D201.1 (K), D202.1 (K), D203.1 (K), D204.1 (K), D205.1 (K), D206.1 (K), D207.1 (K), D208.1 (K), D209.1 (K), U4.7 (QH)
/Display/DCOL17: D210.1 (K), D211.1 (K), D212.1 (K), D213.1 (K), D214.1 (K), D215.1 (K), D216.1 (K), D217.1 (K), D218.1 (K), D219.1 (K), D220.1 (K), D221.1 (K), U5.15 (QA)
/Display/DCOL18: D222.1 (K), D223.1 (K), D224.1 (K), D225.1 (K), D226.1 (K), D227.1 (K), D228.1 (K), D229.1 (K), D230.1 (K), D231.1 (K), D232.1 (K), D233.1 (K), U5.1 (QB)
/Display/DCOL19: D234.1 (K), D235.1 (K), D236.1 (K), D237.1 (K), D238.1 (K), D239.1 (K), D240.1 (K), D241.1 (K), D242.1 (K), D243.1 (K), D244.1 (K), D245.1 (K), U5.2 (QC)
/Display/DCOL20: D246.1 (K), D247.1 (K), D248.1 (K), D249.1 (K), D250.1 (K), D251.1 (K), D252.1 (K), D253.1 (K), D254.1 (K), D255.1 (K), D256.1 (K), D257.1 (K), U5.3 (QD)
/Display/DCOL21: D258.1 (K), D259.1 (K), D260.1 (K), D261.1 (K), D262.1 (K), D263.1 (K), D264.1 (K), D265.1 (K), D266.1 (K), D267.1 (K), D268.1 (K), D269.1 (K), U5.4 (QE)
/Display/DCOL22: D270.1 (K), D271.1 (K), D272.1 (K), D273.1 (K), D274.1 (K), D275.1 (K), D276.1 (K), D277.1 (K), D278.1 (K), D279.1 (K), D280.1 (K), D281.1 (K), U5.5 (QF)
/Display/DCOL23: D282.1 (K), D283.1 (K), D284.1 (K), D285.1 (K), D286.1 (K), D287.1 (K), D288.1 (K), D289.1 (K), D290.1 (K), D291.1 (K), D292.1 (K), D293.1 (K), U5.6 (QG)
/Display/DCOL24: D294.1 (K), D295.1 (K), D296.1 (K), D297.1 (K), D298.1 (K), D299.1 (K), D300.1 (K), D301.1 (K), D302.1 (K), D303.1 (K), D304.1 (K), D305.1 (K), U5.7 (QH)
/Display/DROW1: D18.2 (A), D30.2 (A), D42.2 (A), D54.2 (A), D66.2 (A), D78.2 (A), D90.2 (A), D102.2 (A), D114.2 (A), D126.2 (A), D138.2 (A), D150.2 (A), D162.2 (A), D174.2 (A), D186.2 (A), D198.2 (A), D210.2 (A), D222.2 (A), D234.2 (A), D246.2 (A), D258.2 (A), D270.2 (A), D282.2 (A), D294.2 (A), R14.2
/Display/DROW2: D19.2 (A), D31.2 (A), D43.2 (A), D55.2 (A), D67.2 (A), D79.2 (A), D91.2 (A), D103.2 (A), D115.2 (A), D127.2 (A), D139.2 (A), D151.2 (A), D163.2 (A), D175.2 (A), D187.2 (A), D199.2 (A), D211.2 (A), D223.2 (A), D235.2 (A), D247.2 (A), D259.2 (A), D271.2 (A), D283.2 (A), D295.2 (A), R15.2
/Display/DROW3: D20.2 (A), D32.2 (A), D44.2 (A), D56.2 (A), D68.2 (A), D80.2 (A), D92.2 (A), D104.2 (A), D116.2 (A), D128.2 (A), D140.2 (A), D152.2 (A), D164.2 (A), D176.2 (A), D188.2 (A), D200.2 (A), D212.2 (A), D224.2 (A), D236.2 (A), D248.2 (A), D260.2 (A), D272.2 (A), D284.2 (A), D296.2 (A), R16.2
/Display/DROW4: D21.2 (A), D33.2 (A), D45.2 (A), D57.2 (A), D69.2 (A), D81.2 (A), D93.2 (A), D105.2 (A), D117.2 (A), D129.2 (A), D141.2 (A), D153.2 (A), D165.2 (A), D177.2 (A), D189.2 (A), D201.2 (A), D213.2 (A), D225.2 (A), D237.2 (A), D249.2 (A), D261.2 (A), D273.2 (A), D285.2 (A), D297.2 (A), R17.2
/Display/DROW5: D22.2 (A), D34.2 (A), D46.2 (A), D58.2 (A), D70.2 (A), D82.2 (A), D94.2 (A), D106.2 (A), D118.2 (A), D130.2 (A), D142.2 (A), D154.2 (A), D166.2 (A), D178.2 (A), D190.2 (A), D202.2 (A), D214.2 (A), D226.2 (A), D238.2 (A), D250.2 (A), D262.2 (A), D274.2 (A), D286.2 (A), D298.2 (A), R18.2
/Display/DROW6: D23.2 (A), D35.2 (A), D47.2 (A), D59.2 (A), D71.2 (A), D83.2 (A), D95.2 (A), D107.2 (A), D119.2 (A), D131.2 (A), D143.2 (A), D155.2 (A), D167.2 (A), D179.2 (A), D191.2 (A), D203.2 (A), D215.2 (A), D227.2 (A), D239.2 (A), D251.2 (A), D263.2 (A), D275.2 (A), D287.2 (A), D299.2 (A), R19.2
/Display/DROW7: D24.2 (A), D36.2 (A), D48.2 (A), D60.2 (A), D72.2 (A), D84.2 (A), D96.2 (A), D108.2 (A), D120.2 (A), D132.2 (A), D144.2 (A), D156.2 (A), D168.2 (A), D180.2 (A), D192.2 (A), D204.2 (A), D216.2 (A), D228.2 (A), D240.2 (A), D252.2 (A), D264.2 (A), D276.2 (A), D288.2 (A), D300.2 (A), R20.2
/Display/DROW8: D25.2 (A), D37.2 (A), D49.2 (A), D61.2 (A), D73.2 (A), D85.2 (A), D97.2 (A), D109.2 (A), D121.2 (A), D133.2 (A), D145.2 (A), D157.2 (A), D169.2 (A), D181.2 (A), D193.2 (A), D205.2 (A), D217.2 (A), D229.2 (A), D241.2 (A), D253.2 (A), D265.2 (A), D277.2 (A), D289.2 (A), D301.2 (A), R21.2
/Display/DROW9: D26.2 (A), D38.2 (A), D50.2 (A), D62.2 (A), D74.2 (A), D86.2 (A), D98.2 (A), D110.2 (A), D122.2 (A), D134.2 (A), D146.2 (A), D158.2 (A), D170.2 (A), D182.2 (A), D194.2 (A), D206.2 (A), D218.2 (A), D230.2 (A), D242.2 (A), D254.2 (A), D266.2 (A), D278.2 (A), D290.2 (A), D302.2 (A), R22.2
/Display/DROW10: D27.2 (A), D39.2 (A), D51.2 (A), D63.2 (A), D75.2 (A), D87.2 (A), D99.2 (A), D111.2 (A), D123.2 (A), D135.2 (A), D147.2 (A), D159.2 (A), D171.2 (A), D183.2 (A), D195.2 (A), D207.2 (A), D219.2 (A), D231.2 (A), D243.2 (A), D255.2 (A), D267.2 (A), D279.2 (A), D291.2 (A), D303.2 (A), R23.2
/Display/DROW11: D28.2 (A), D40.2 (A), D52.2 (A), D64.2 (A), D76.2 (A), D88.2 (A), D100.2 (A), D112.2 (A), D124.2 (A), D136.2 (A), D148.2 (A), D160.2 (A), D172.2 (A), D184.2 (A), D196.2 (A), D208.2 (A), D220.2 (A), D232.2 (A), D244.2 (A), D256.2 (A), D268.2 (A), D280.2 (A), D292.2 (A), D304.2 (A), R24.2
/Display/DROW12: D29.2 (A), D41.2 (A), D53.2 (A), D65.2 (A), D77.2 (A), D89.2 (A), D101.2 (A), D113.2 (A), D125.2 (A), D137.2 (A), D149.2 (A), D161.2 (A), D173.2 (A), D185.2 (A), D197.2 (A), D209.2 (A), D221.2 (A), D233.2 (A), D245.2 (A), D257.2 (A), D269.2 (A), D281.2 (A), D293.2 (A), D305.2 (A), R25.2
GND: U3.8 (GND), U3.13 (~OE), U4.8 (GND), U4.13 (~OE), U5.8 (GND), U5.13 (~OE); also elsewhere on the board
unnamed: U3.9 (QH'), U4.14 (SER)
unnamed: U4.9 (QH'), U5.14 (SER)

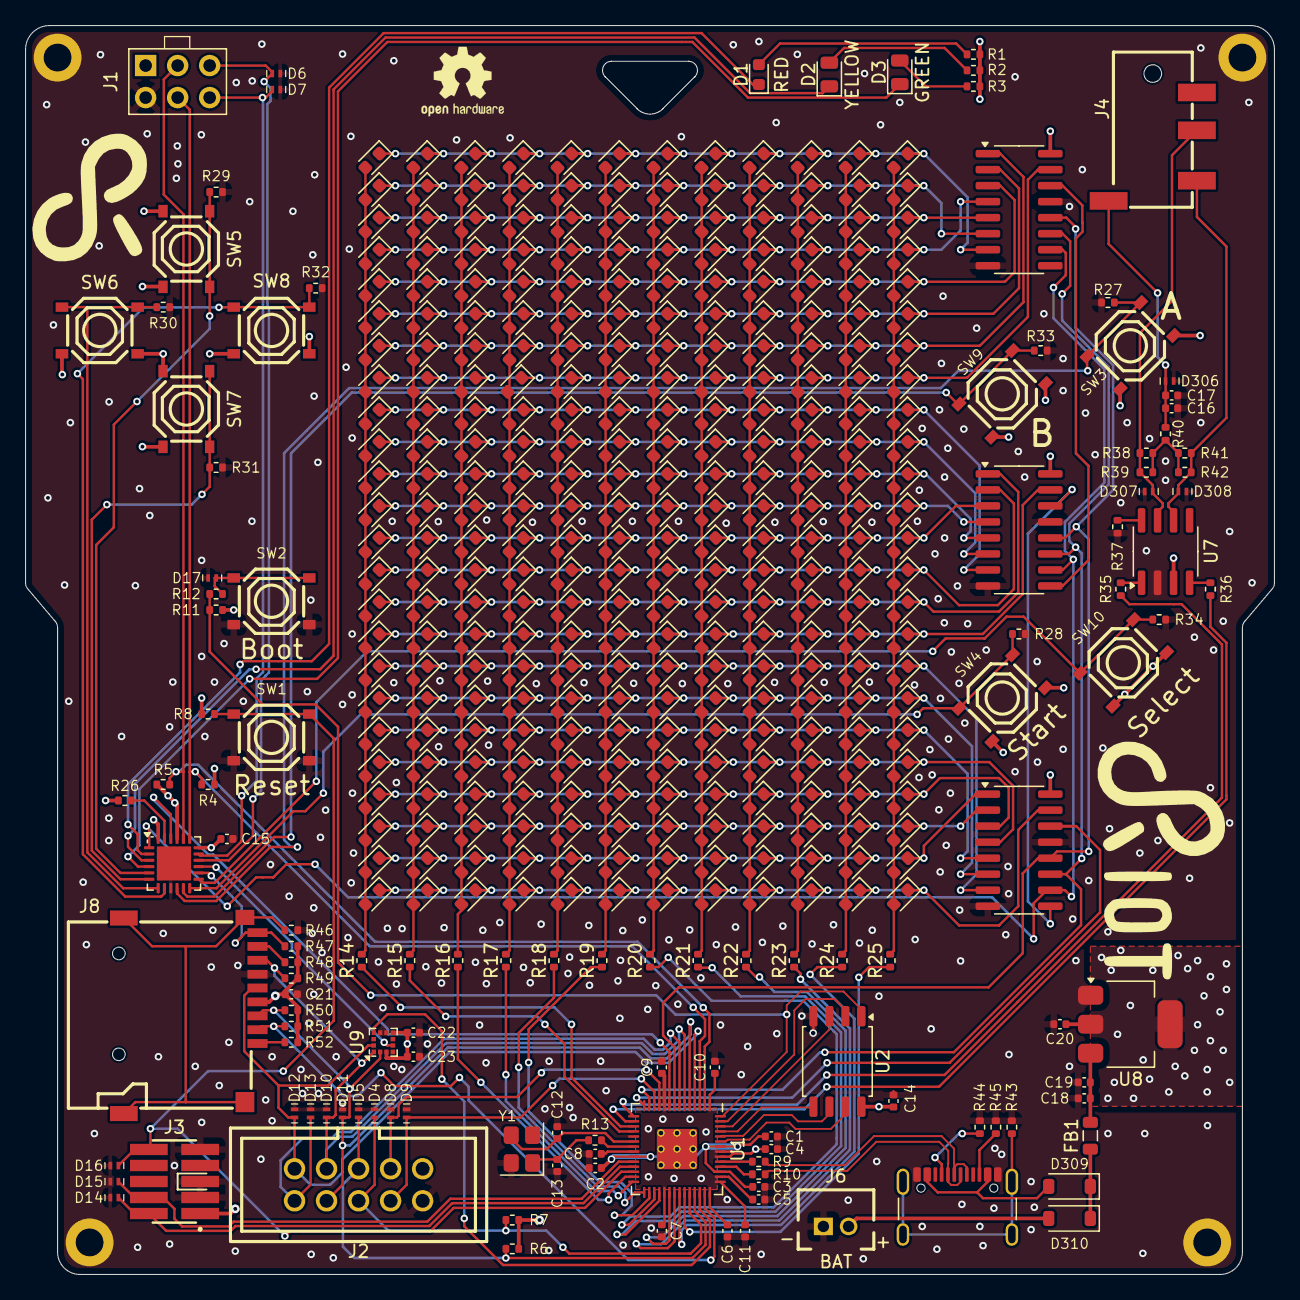
[picture p9: board riot-badge.kicad_pcb from above]

Board: 4 copper layers, 99.1 x 99.1 mm, 418 parts (0 on the bottom side), 125 nets.
