maribu/badge-wip/(commit log)

2025-07-28 Add badge schematics
    [buttons.kicad_sch, can_transceiver.kicad_sch, display.kicad_sch, mcu.kicad_sch, riot-badge.kicad_sch]
2025-07-29 wip! add concept PCB design
    [mcu.kicad_sch]
2025-08-04 Updated badge based on feedback from badge.team
    [buttons.kicad_sch, can_transceiver.kicad_sch, display.kicad_sch, gpio_extender.kicad_sch, mcu.kicad_sch, power_usb.kicad_sch, riot-badge.kicad_sch]
2025-08-04 bom: fix using inconsistent value for same part
    [power_usb.kicad_sch]
2025-08-31 Schematics: Add uSD card holder & VBAT sensing
    [gpio_extender.kicad_sch, power_usb.kicad_sch, riot-badge.kicad_sch, sd_card.kicad_sch]
2025-09-04 Schematics: Add accelerometer, drop VBAT sensing
    Adding a cheap accelerometer to the boards, sacraficing the VBAT input
    to make room for the /CS pin.
    [accelerometer.kicad_sch, can_transceiver.kicad_sch, power_usb.kicad_sch, riot-badge.kicad_sch, sd_card.kicad_sch]
2025-09-04 board: updated to schematics
    [riot-badge.kicad_pcb]
2025-09-30 schematic: Fixed LCSC part number for R45
    [power_usb.kicad_sch]
2025-09-30 PCB: Add draft silkscreen decoration
    [riot-badge.kicad_pcb]
